JavaPowerFR/SCS/README.md

# SCS
SCS Interface For MyHOME Products Legrand BTicino
