JavaPowerFR/SCS/Hardware/04_reverse_engineering.jpg

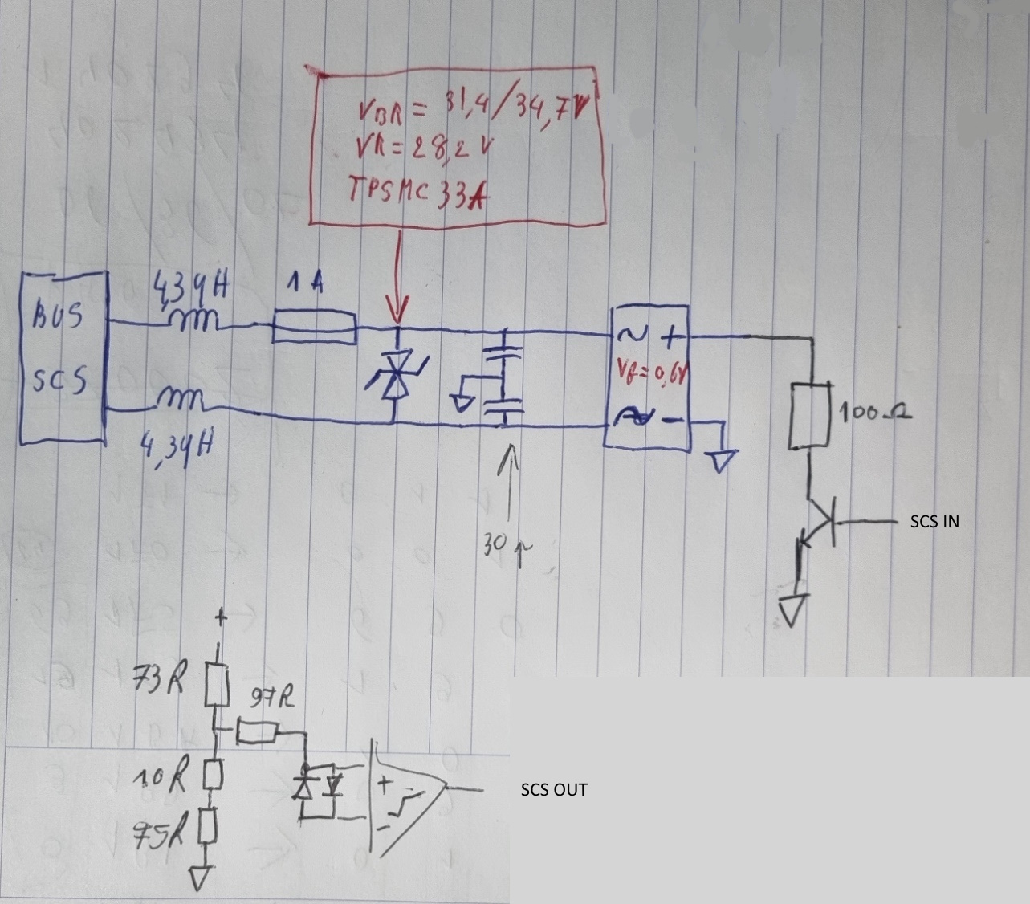
Hardware/04_reverse_engineering.jpg
