JavaPowerFR/SCS/Hardware/First_Interface_bb.jpg

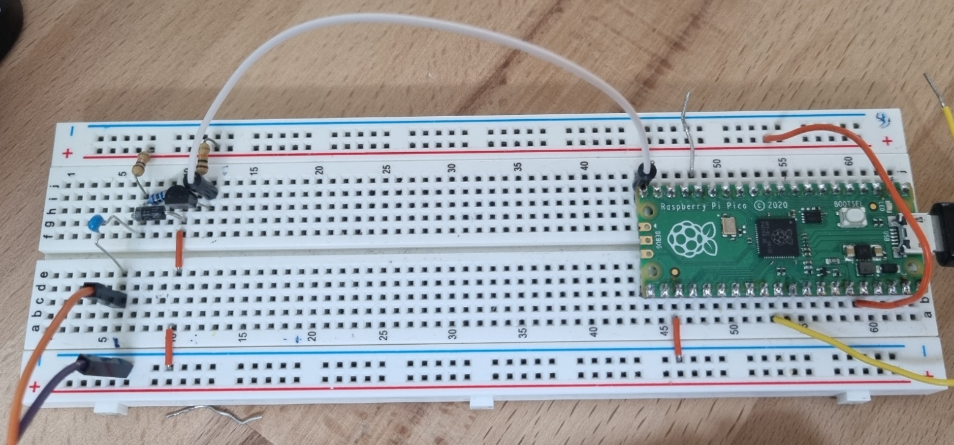
Hardware/First_Interface_bb.jpg
