JavaPowerFR/SCS/Hardware/First_Interface_ocilo.png

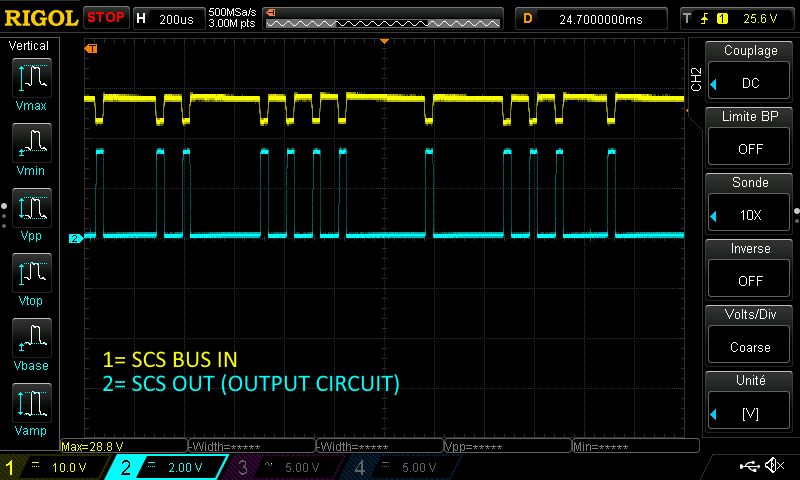
Hardware/First_Interface_ocilo.png
