JavaPowerFR/SCS/Hardware/First_Interface_schematic.png

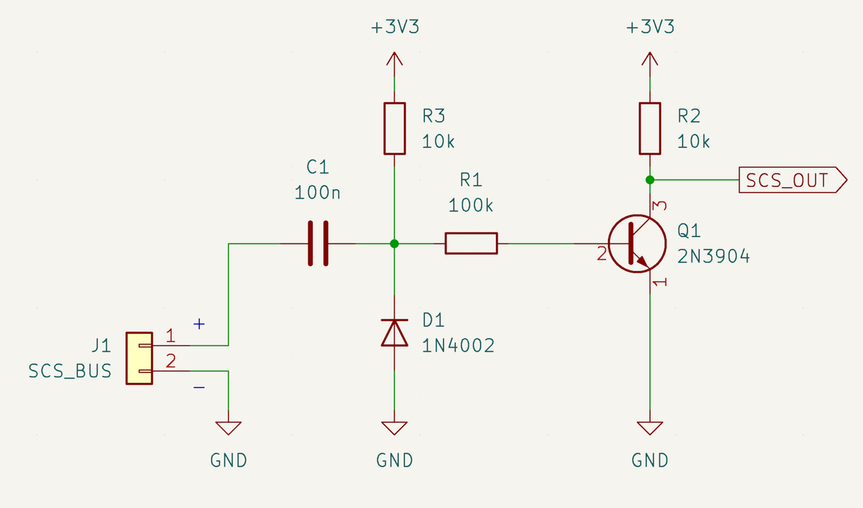
Hardware/First_Interface_schematic.png
