JavaPowerFR/SCS/Hardware/SCS Interface V1/3D_lte_V1.png

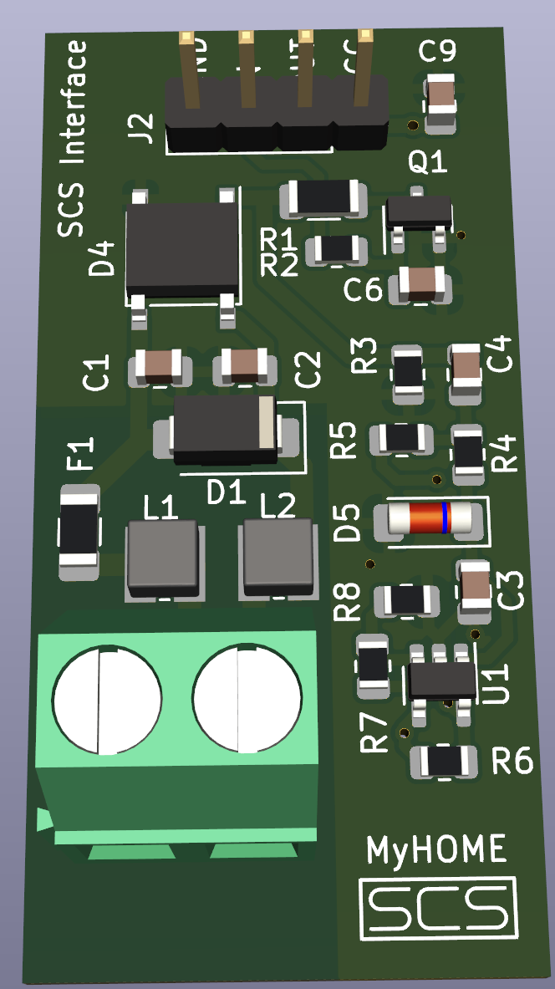
Hardware/SCS Interface V1/3D_lte_V1.png
