JavaPowerFR/SCS/Hardware/SCS Interface V1/3D_with_power_V1.png

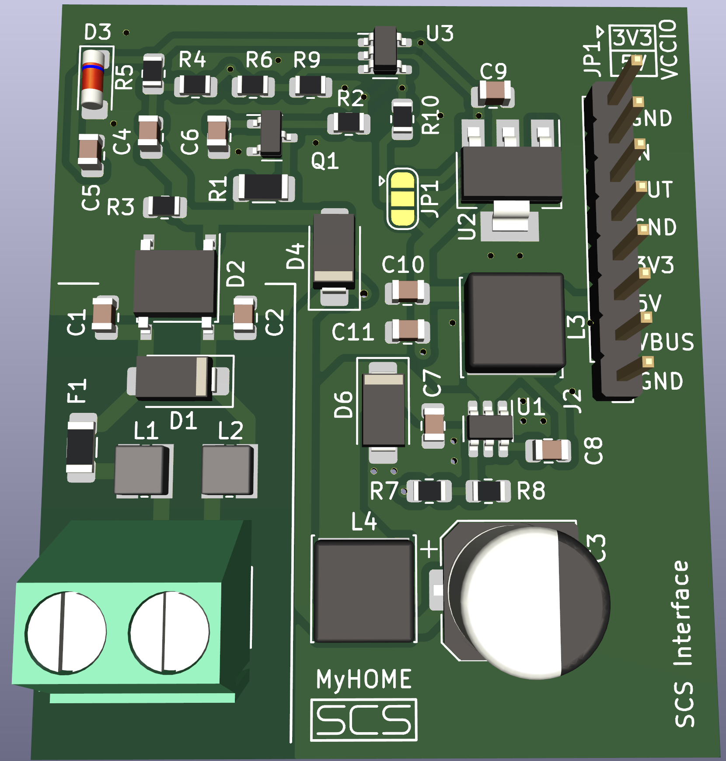
Hardware/SCS Interface V1/3D_with_power_V1.png
