JavaPowerFR/SCS/Hardware/SCS Interface V1/PCB_lte_V1.png

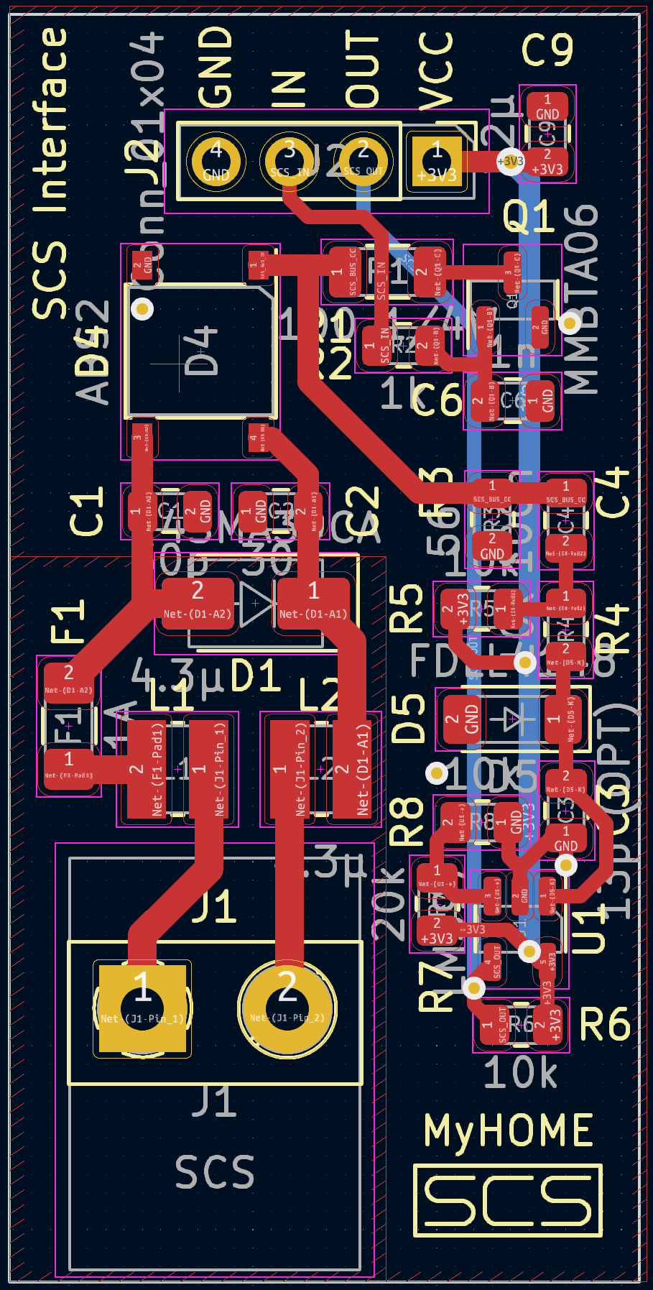
Hardware/SCS Interface V1/PCB_lte_V1.png
