JavaPowerFR/SCS/Hardware/SCS Interface V1/PCB_with_power_V1.png

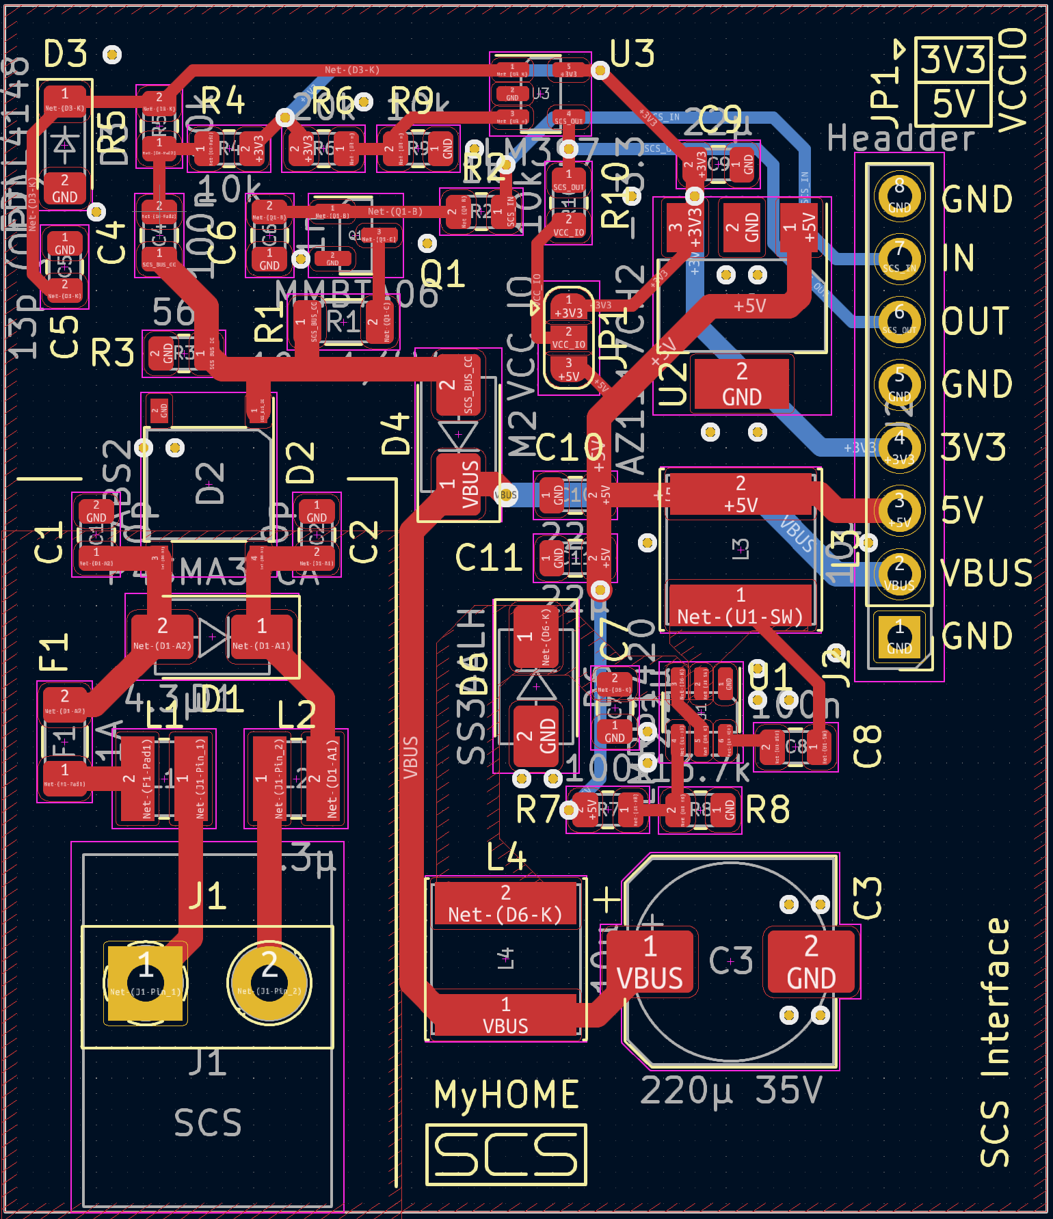
Hardware/SCS Interface V1/PCB_with_power_V1.png
