JavaPowerFR/SCS/Hardware/SCS Interface V1/schematic_with_power_V1.png

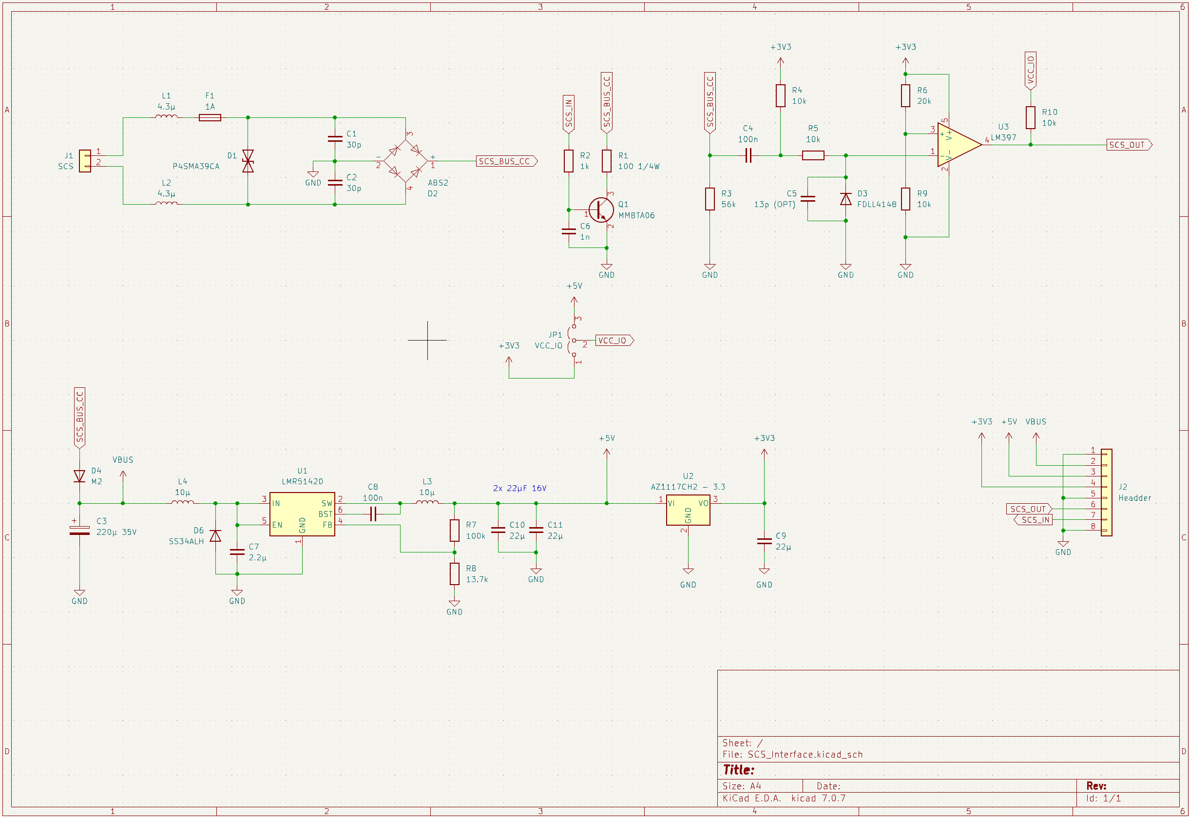
Hardware/SCS Interface V1/schematic_with_power_V1.png
