JavaPowerFR/SCS/Software/Decryptor Application/bp_1_ON_OFF.png

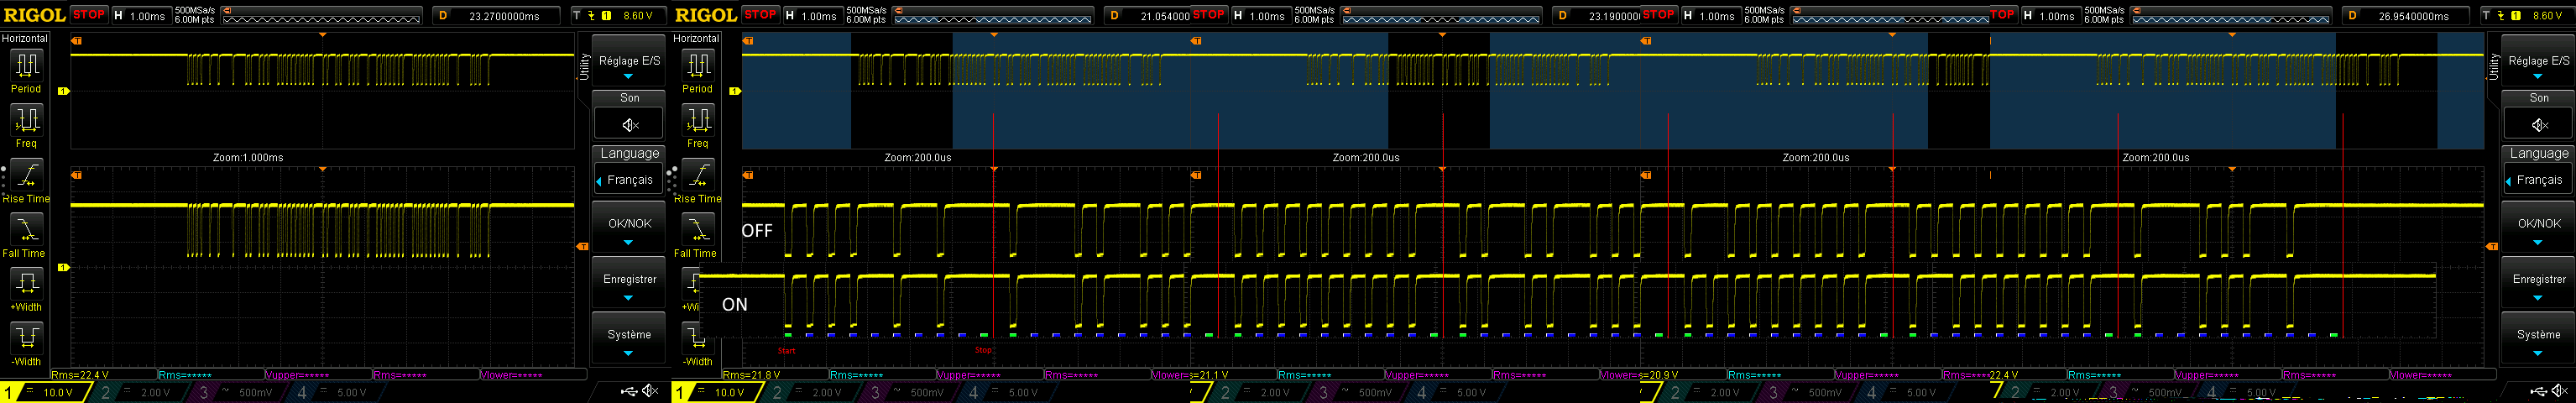
Software/Decryptor Application/bp_1_ON_OFF.png
