JavaPowerFR/SCS/Software/Decryptor Application/protocol_and_timming.png

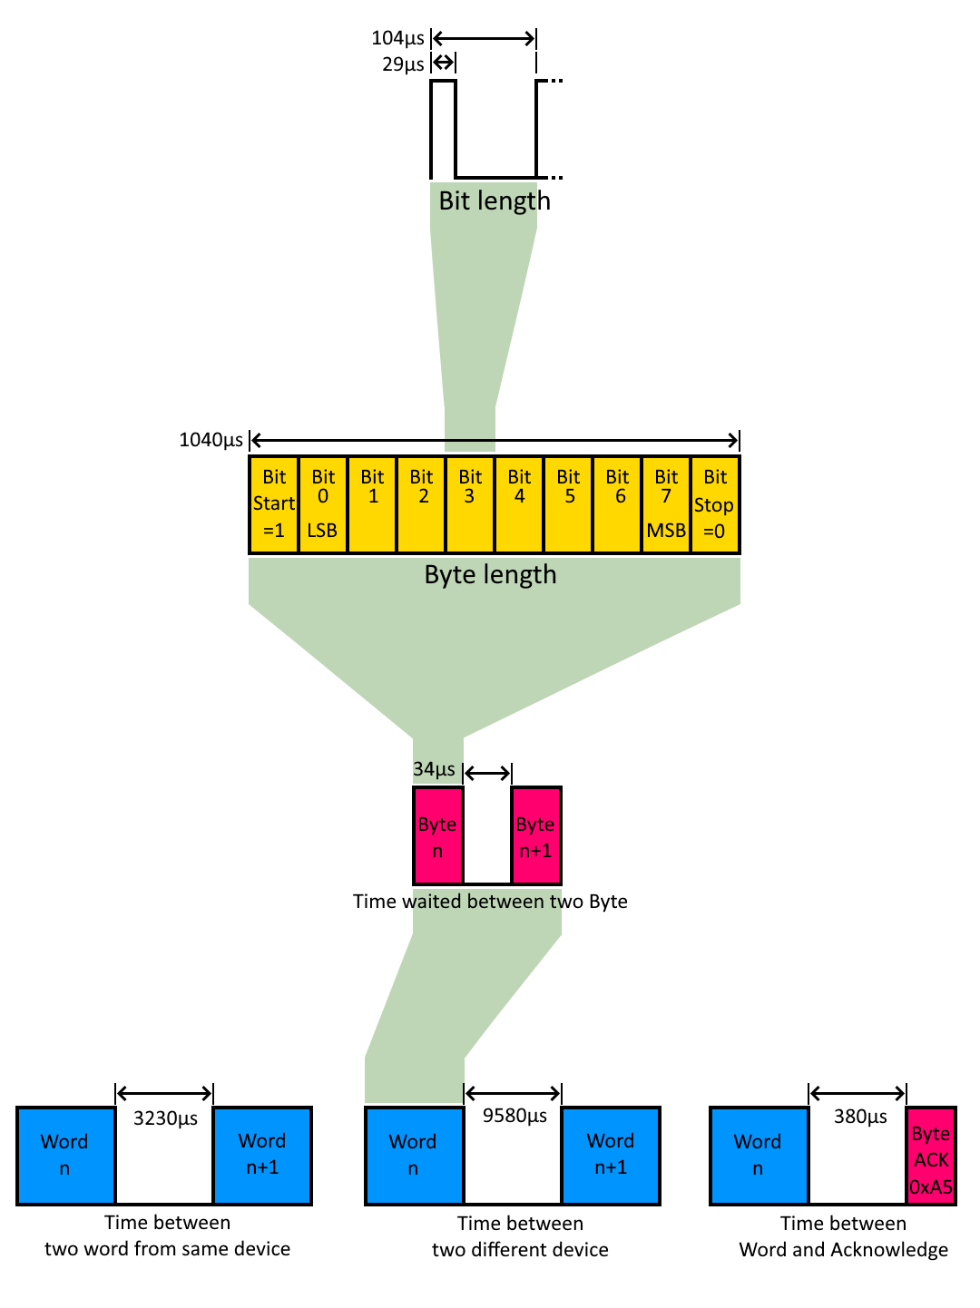
Software/Decryptor Application/protocol_and_timming.png
