JavaPowerFR/SCS/Resources/OPENDB_EN_OPEN.xlsx

Sheet: OPENDB_EN_OPEN
id_open | open_label | descr | open_string | scs_command | has_address | has_param | open_type | diag_open | error_open | open4keyo | note
1 | res_object_model | device answer its object model and number of physical configurator | *#[WHO]*[WHERE]*1*[OBJECT_MODEL]*[N_CONF]*[BRAND]*[LINE]## | 0xD2:[WHERE]:[TYPE]:0x34:0x80:[N_CONF]:[BRAND_LINE]:[OBJECT_MODEL] | 1 | 1 | 0 | 1 | 0 | 0
2 | res_fw_version | device answer its firmware version | *#[WHO]*[WHERE]*2*[FW_VERSION]## | 0xD2:[WHERE]:[TYPE]:0x34:0x81:[VERSION]:[V_RELEASE]:[V_BUILD] | 0 | 1 | 0 | 1 | 0 | 0
3 | res_hw_version | device answer its hardware version | *#[WHO]*[WHERE]*3*[HW_VERSION]## | 0xD2:[WHERE]:[TYPE]:0x34:0x82:[VERSION]:[V_RELEASE]:[V_BUILD] | 0 | 1 | 0 | 1 | 0 | 0
4 | res_conf_1_6 | device answer its configurator from 1 to 6 | *#[WHO]*[WHERE]*4*[C1]*[C2]*[C3]*[C4]*[C5]*[C6]## | 0xD2:[WHERE]:[TYPE]:0x34:0x83:[C1_C2]:[C3_C4]:[C5_C6] | 0 | 1 | 0 | 1 | 0 | 0
5 | res_conf_7_12 | device answer its configurator from 7 to 12 | *#[WHO]*[WHERE]*5*[C7]*[C8]*[C9]*[C10]*[C11]*[C12]## | 0xD2:[WHERE]:[TYPE]:0x34:0x84:[C7_C8]:[C9_C10]:[C11_C12] | 0 | 1 | 0 | 1 | 0 | 0
6 | res_micro_version | device answer its micro version | *#[WHO]*[WHERE]*6*[MICRO_VERSION]## | 0xD2:[WHERE]:[TYPE]:0x34:0x85:[VERSION]:[V_RELEASE]:[V_BUILD] | 0 | 1 | 0 | 1 | 0 | 0
7 | res_diag_a | device answer its diagnostic bitmask A | *#[WHO]*[WHERE]*7*[BITMASK_DIA_A]## | 0xD2:[WHERE]:[TYPE]:0x34:0x86:[BITMASK_DIA_A_3]:[BITMASK_DIA_A_2]:[BITMASK_DIA_A_1] | 0 | 1 | 0 | 1 | 0 | 0
8 | res_diag_b | device answer its diagnostic bitmask B | *#[WHO]*[WHERE]*8*[BITMASK_DIA_B]## | 0xD2:[WHERE]:[TYPE]:0x34:0x87:[BITMASK_DIA_B_3]:[BITMASK_DIA_B_2]:[BITMASK_DIA_B_1] | 0 | 1 | 0 | 1 | 0 | 0
9 | res_trans_end | device answer end of transmission | *[WHO]*4*[WHERE_FAKE]## | 0xD2:[WHERE]:[TYPE]:0x34:0x8C:0x00:0x00:0xAA | 1 | 0 | 0 | 1 | 0 | 0
10 | res_conf_wrong | device answer for wrong configuration | *[WHO]*51*[WHERE_FAKE]## | 0xD2:[WHERE]:[TYPE]:0x34:0x8C:0x00:0x00:0xEE | 1 | 0 | 0 | 1 | 1 | 0
11 | cmd_conf_end | programmer send end of configuration | *[WHO]*2*0## | 0xD2:0x00:[TYPE]:0x32:0x8C:0x00:0x00:0xFF | 0 | 0 | 1 | 1 | 0 | 0
12 | cmd_conf_abort | device abort configuration | *[WHO]*3*0## | 0xD2:0x00:[TYPE]:0x34:0x8C:0x00:[STATUS]:0xFA | 0 | 0 | 0 | 1 | 2 | 0
13 | cmd_conf_abort | programmer abort configuration | *[WHO]*3*0## | 0xD2:0x00:[TYPE]:0x32:0x8C:0x00:[STATUS]:0xFA | 0 | 0 | 1 | 1 | 0 | 0
14 | cmd_conf_del | programmer delete the configuration stored in the device memory | *[WHO]*7*0## | 0xD2:0x00:[TYPE]:0x32:0x8C:0x00:0x01:0xF0 | 0 | 0 | 1 | 1 | 0 | 0
15 | cmd_conf_start | programmer start configuration session | *[WHO]*1*0## | 0xD2:0x00:[TYPE]:0x32:0x8C:0x00:0x00:0x00 | 0 | 0 | 1 | 1 | 0 | 0
16 | cmd_trans_end | programmer answer end of transmission | *[WHO]*4*0## | 0xD2:0x00:[TYPE]:0x32:0x8C:0x00:0x00:0xAA | 0 | 0 | 1 | 1 | 0 | 0
17 | res_conf_ok | device answer configuration ok | *[WHO]*52*[WHERE_FAKE]## | 0xD2:[WHERE]:[TYPE]:0x34:0x8C:0x00:0x00:0xAB | 1 | 0 | 0 | 1 | 0 | 0
18 | cmd_conf_ID | programmer start configuration session with ID | *[WHO]*9#[ID]*0## | 0xD0:0x00:[TYPE]:0xF6:[DEVICE_ID_3]:[DEVICE_ID_2]:[DEVICE_ID_1]:[DEVICE_ID_0] | 0 | 1 | 1 | 1 | 0 | 0
19 | cmd_conf_start_add | programmer start configuration session with address | *[WHO]*1*[WHERE]## | 0xD2:[WHERE]:[TYPE]:0x32:0x8C:0x00:0x00:0x00 | 1 | 0 | 1 | 1 | 0 | 0
20 | res_id | device answer its ID | *#[WHO]*[WHERE]*13*[ID]## | 0xD0:[WHERE]:[TYPE]:0x04:[DEVICE_ID_3]:[DEVICE_ID_2]:[DEVICE_ID_1]:[DEVICE_ID_0] | 0 | 1 | 0 | 1 | 0 | 0
21 | res_ko_value | device answer its key_object, value and the state | *#[WHO]*[WHERE]*30*[SLOT]*[KEYO]*[STATE]## | 0xD2:[WHERE]:[TYPE]:0x34:0x8B:[KEYO_2]:[KEYO_1]:[SLOT] | 0 | 1 | 0 | 1 | 0 | 0
22 | res_ko_sys | device answer its key_object, system and address | *#[WHO]*[WHERE]*32#[SLOT]*[SYS]*[ADDR]## | 0xD2:[WHERE]:[TYPE]:0x34:0x8D:[SYS]:[ADDR]:[SLOT]>0x7F | 0 | 1 | 0 | 1 | 0 | 0
23 | cmd_conf_1_6 | programmer send the configuration of the configurators from 1 to 6 | *#[WHO]*0*#4*[C1]*[C2]*[C3]*[C4]*[C5]*[C6]## | 0xD2:0x00:[TYPE]:0x32:0x83:[C1_C2]:[C3_C4]:[C5_C6] | 0 | 1 | 1 | 1 | 0 | 0
24 | cmd_conf_7_12 | programmer send the configuration of the configurators from 7 to 12 | *#[WHO]*0*#5*[C7]*[C8]*[C9]*[C10]*[C11]*[C12]## | 0xD2:0x00:[TYPE]:0x32:0x84:[C7_C8]:[C9_C10]:[C11_C12] | 0 | 1 | 1 | 1 | 0 | 0
26 | res_param_ko | device answer the parameters of ko | *#[WHO]*[WHERE]*35#[INDEX]#[SLOT]*[VAL_PAR]## | 0xD2:[WHERE]:[TYPE]:0x34:0x8D:[VAL_PAR]:[INDEX]:[SLOT] | 0 | 1 | 0 | 1 | 0 | 0
27 | cmd_reset_all_ko | programmer reset all KO of device | *[WHO]*14#0*0## | 0xD2:0x00:[TYPE]:0x32:0x8B:0x00:0x00:0x80 | 0 | 0 | 1 | 1 | 0 | 0
28 | cmd_reset_ko | programmer reset a specific KO of device | *[WHO]*14#[SLOT]*0## | 0xD2:0x00:[TYPE]:0x32:0x8B:0x00:0x00:[SLOT]>0x80 | 0 | 1 | 1 | 1 | 0 | 1
29 | cmd_ko_value | programmer send the configuration of key_object, value | *#[WHO]*0*#30*[SLOT]*[KEYO]## | 0xD2:0x00:[TYPE]:0x32:0x8B:[KEYO_2]:[KEYO_1]:[SLOT] | 0 | 1 | 1 | 1 | 0 | 1
30 | cmd_ko_sys | programmer send the configuration of key_object, system and address | *#[WHO]*0*#32#[SLOT]*[SYS]*[ADDR]## | 0xD2:0x00:[TYPE]:0x42:0x8D:[SYS]:[ADDR]:[SLOT]>0x7F | 0 | 1 | 1 | 1 | 0 | 1
31 | cmd_param_ko | programmer send the configuration of the parameters of ko | *#[WHO]*0*#35#[INDEX]#[SLOT]*[VAL_PAR]## | 0xD2:0x00:[TYPE]:0x32:0x8D:[VAL_PAR]:[INDEX]:[SLOT] | 0 | 1 | 1 | 1 | 0 | 1
32 | cmd_diag_start | programmer start diagnostic session | *[WHO]*5*0## | 0xD2:0x00:[TYPE]:0x32:0x8C:0x00:0x01:0x00 | 0 | 0 | 1 | 1 | 0 | 0
33 | cmd_diag_start_add | programmer start diagnostic session with address | *#[WHO]*[WHERE]*0## | 0xD1:[WHERE]:[INTERFACE_TYPE]:0x42:0x8C:0x00:0x01:0x00 | 1 | 0 | 1 | 1 | 0 | 0
34 | cmd_diag_ID | programmer start diagnostic session with ID | *[WHO]*10#[ID]*0## | 0xD0:0x00:[TYPE]:0xF7:[DEVICE_ID_3]:[DEVICE_ID_2]:[DEVICE_ID_1]:[DEVICE_ID_0] | 0 | 1 | 1 | 1 | 0 | 0
35 | cmd_diag_abort | programmer abort diagnostic | *[WHO]*6*0## | 0xD2:0x00:[TYPE]:0x32:0x8C:0x00:0x01:0xFF | 0 | 0 | 1 | 1 | 0 | 0
36 | res_unset_ko_error | device answer KO not implemented | *#[WHO]*[WHERE]*31*[SLOT]*0*[STATE]## | 0xD2:[WHERE]:[TYPE]:0x34:0x8B:0xFF:0x00:[SLOT_STATE] | 0 | 1 | 0 | 1 | 1 | 1
37 | res_busy_ko_error | device answer KO busy | *#[WHO]*[WHERE]*31*[SLOT]*1*[STATE]## | 0xD2:[WHERE]:[TYPE]:0x34:0x8B:0xFF:0x01:[SLOT_STATE] | 0 | 1 | 0 | 1 | 2 | 0 | this error open is marked as error_open=2 because it can happen even during a dignosis sequance and it is just an info
38 | res_done_ko_error | device answer KO already configured | *#[WHO]*[WHERE]*31*[SLOT]*2*[STATE]## | 0xD2:[WHERE]:[TYPE]:0x34:0x8B:0xFF:0x02:[SLOT_STATE] | 0 | 1 | 0 | 1 | 1 | 1
39 | res_full_ko_error | device answer there are not enough free KO | *#[WHO]*[WHERE]*31*[SLOT]*3*[STATE]## | 0xD2:[WHERE]:[TYPE]:0x34:0x8B:0xFF:0x03:[SLOT_STATE] | 0 | 1 | 0 | 1 | 1 | 1
40 | res_wrong_ko_error | device answer not implemented this KO | *#[WHO]*[WHERE]*31*[SLOT]*4*[STATE]## | 0xD2:[WHERE]:[TYPE]:0x34:0x8B:0xFF:0x04:[SLOT_STATE] | 0 | 1 | 0 | 1 | 1 | 1 | State = 0x80
41 | res_addr_ko_error | device answer KO address error | *#[WHO]*[WHERE]*34*[SLOT]*[ERROR]## |  | 0 | 1 | 0 | 1 | 1 | 1
42 | res_param_ko_error | device answer parameter of KO error | *#[WHO]*[WHERE]*39*[SLOT]*[INDEX]*[ERROR]## |  | 0 | 1 | 0 | 1 | 2 | 1 | this error open is marked as error_open=2 because some parameters can be unmanaged by the device but the error should not stop the configuration
43 | cmd_scan_room | programmer start scan for room | *#[WHO]*[A]*1## | 0xD5:[WHERE_IID_A]:[TYPE]:0x43:0x80:0x00:0x00:0x00 | 0 | 1 | 1 | 1 | 0 | 0
44 | cmd_reset | programmer delete from memory the previous scans | *[WHO]*12*0## | 0xD0:0x00:[TYPE]:0xFB:0x00:0x00:0x00:0x00 | 0 | 0 | 1 | 1 | 0 | 0
45 | cmd_scan_all | programmer start scan for all devices with ID | *#[WHO]*0*13## | 0xD0:0x00:[TYPE]:0xF3:0x00:0x00:0x00:0x00 | 0 | 0 | 1 | 1 | 0 | 0
46 | cmd_scan_conf | programmer start scan for only devices configured with ID | *#[WHO]*0*13#1## | 0xD0:0x00:[TYPE]:0xF9:0x00:0x00:0x00:0x00 | 0 | 0 | 1 | 1 | 0 | 0
47 | cmd_scan_notconf | programmer start scan for only devices not configured with ID | *#[WHO]*0*13#0## | 0xD0:0x00:[TYPE]:0xF8:0x00:0x00:0x00:0x00 | 0 | 0 | 1 | 1 | 0 | 0
48 | cmd_scan_check | programmer send flag to all the devices found | *[WHO]*11#[ID]*0## | 0xD0:0x00:[TYPE]:0xFA:[DEVICE_ID_3]:[DEVICE_ID_2]:[DEVICE_ID_1]:[DEVICE_ID_0] | 0 | 1 | 1 | 1 | 0 | 0
49 | cmd_scan_term | programmer start scan of termoregulation | *#[WHO]*00[ZAZB]*1## | /!\ 0xD5:[ZAZB]:0x03:0x33:0x80:0x00:0x00:0x00 | 0 | 1 | 1 | 1 | 0 | 0
50 | cmd_test | programmer send test | *[WHO]*[WHAT]*[WHERE]## |  | 1 | 1 | 1 | 0 | 0 | 0
51 | res_test | device answer test | *[WHO]*[WHAT]*[WHERE]## |  | 0 | 1 | 0 | 0 | 0 | 0
52 | cmd_lux | programmer sent level of LUX | *#[WHO]*[WHERE]*6## |  | 1 | 0 | 1 | 0 | 0 | 0
53 | res_lux | device answer level of LUX | *#[WHO]*[WHERE]*6*[LEVELLUX]## |  | 1 | 1 | 0 | 0 | 0 | 0
54 | cmd_tar_start | programmer star calibration | *[WHO]*1000#33#1*[WHERE]## |  | 1 | 0 | 1 | 0 | 0 | 0
55 | cmd_tar_end | programmer end calibration | *[WHO]*1000#33#0*[WHERE]## |  | 1 | 0 | 1 | 0 | 0 | 0
56 | res_tar_ok | device send start/end calibration | *[WHO]*33#1*[WHERE]## |  | 0 | 0 | 0 | 0 | 0 | 0
57 | cmd_lux_conf | programmer send the configuration of level of LUX | *#[WHO]*[WHERE]*#6*[LEVELLUX]## |  | 1 | 1 | 1 | 0 | 0 | 0
58 | res_lux_conf | device answer the configuration of level of LUX | *#[WHO]*[WHERE]*#6*[LEVELLUX]## |  | 0 | 1 | 0 | 0 | 0 | 0
59 | cmd_ident | programmer send open identification code for the service | *[WHO]*[WHAT]## |  | 0 | 1 | 1 | 0 | 0 | 0
60 | res_oper | device answer the caller a string representing the sequence of logic operations to be applied to the password | *#[OPERATIONS]## |  | 0 | 1 | 0 | 0 | 0 | 0
61 | cmd_result | programmer send the result of password | *#[RESULT]## |  | 0 | 1 | 1 | 0 | 0 | 0
62 | cmd_diag_general | programmer send the request of general diagnostic A of device system | *#[WHO]**7## |  | 0 | 0 | 1 | 1 | 0 | 0
63 | res_diag_bit | device answer the mask of autodiagnostic | *#[WHO]**7*[BIT]## |  | 0 | 1 | 0 | 1 | 0 | 0
64 | res_autodiag_bit | device answer the mask of autodiagnostic when there are problems hardware/software | *#[WHO]**11*[BIT]## |  | 0 | 1 | 0 | 1 | 0 | 0
65 | cmd_webserver | programmer send model of WebServer | *#[WHO]**15## |  | 0 | 0 | 1 | 0 | 0 | 0
66 | cmd_mac | programmer send mac address | *#[WHO]**12## |  | 0 | 0 | 1 | 0 | 0 | 0
67 | res_webserver | device answer object_model of WebServer | *#[WHO]**15*[OBJECT_MODEL]## |  | 0 | 1 | 0 | 0 | 0 | 0
68 | res_mac | device answer mac address | *#[WHO]**12*[MAC1]*[MAC2]*[MAC3]*[MAC4]*[MAC5]*[MAC6]## |  | 0 | 1 | 0 | 0 | 0 | 0
69 | cmd_prog_sce_start | programmer start of programming of scenario | *[WHO]*15#1[SCE]*0## |  | 0 | 1 | 1 | 1 | 0 | 0
70 | cmd_reset_sce | programmer send to reset scenario | *[WHO]*18#1[SCE]*0## |  | 0 | 1 | 1 | 1 | 0 | 0
72 | cmd_prog_sce_end | programmer end of programming of scenario | *[WHO]*16#1[SCE]*0## |  | 0 | 1 | 1 | 1 | 0 | 0
73 | cmd_set_state | programmer send to set PPT_SCE state | *#[WHO]*[WHERE]*#40#1[SCE]*[STATE_SCE]## |  | 1 | 1 | 1 | 1 | 0 | 0
74 | cmd_state | programmer send the state of scenario | *#[WHO]*[WHERE]*40#1[SCE]## |  | 1 | 1 | 1 | 1 | 0 | 0
75 | res_state | device answer the state of scenario | *#[WHO]*[WHERE]*40#1[SCE]*[STATE_SCE]## |  | 0 | 1 | 0 | 1 | 0 | 0
76 | res_error_sce | device answer with error to the scenario | *#[WHO]*[WHERE]*41#1[SCE]*[ERROR]## |  | 0 | 1 | 0 | 1 | 1 | 0
77 | cmd_test_sce | programmer sent scenario activation | *[WHO]*11#0*1[SCE]## |  | 0 | 1 | 1 | 0 | 0 | 0
78 | res_param_ko_special | device answer the special parameter of ko | *#[WHO]*[WHERE]*310*[SLOT]*[VAL_PAR]## |  | 0 | 1 | 0 | 1 | 0 | 0
79 | ack | ack | *#*1## | 0xA5 | 0 | 0 | 0 | 0 | 0 | 0
80 | nack | nack | *#*0## |  | 0 | 0 | 0 | 0 | 0 | 0
81 | ack | ack | *#*1## | 0xA5 | 0 | 0 | 1 | 0 | 0 | 0
82 | nack | nack | *#*0## |  | 0 | 0 | 1 | 0 | 0 | 0
83 | cmd_param_all_ko | reset keyo on all slot | *#[WHO]*0*38#0## | 0xD2:0x00:[TYPE]:0x33:0x8D:0x06:0x00:0x00 | 0 | 0 | 1 | 1 | 0 | 0 | the same command as ID OPEN 25 reset all slot
25 | cmd_param_ko | reset keyo on selected slot | *#[WHO]*0*38#[SLOT]## |  | 0 | 1 | 1 | 1 | 0 | 0 | the same command as ID OPEN 83 reset a specific slot
84 | cmd_diag_abort | device abort diagnostic | *[WHO]*6*0## |  | 0 | 0 | 0 | 0 | 2 | 0
85 | cmd_scan_start_addr | programmer start scan session with address | *#[WHO]*[WHERE]*1## |  | 1 | 0 | 1 | 0 | 0 | 0
86 | res_trans_end | device answer end of transmission | *[WHO]*4*0## |  | 0 | 0 | 0 | 1 | 0 | 0 | variant of id open = 9
87 | res_conf_wrong | device answer for wrong configuration | *[WHO]*51*0## |  | 0 | 0 | 0 | 1 | 1 | 0 | variant of id open = 10
88 | res_conf_ok | device answer configuration ok | *[WHO]*52*0## |  | 0 | 0 | 0 | 1 | 0 | 0 | variant of id open = 17
89 | res_object_model_gateway | gateway answer its object model and number of physical configurator | *#[WHO]**1*[OBJECT_MODEL]*[N_CONF]*[BRAND]*[LINE]## |  | 1 | 1 | 0 | 1 | 0 | 0

Sheet: Feuil1
1 | res_object_model | device answer its object model and number of physical configurator | *#[WHO]*[WHERE]*1*[OBJECT_MODEL]*[N_CONF]*[BRAND]*[LINE]## | 0xD2 | [WHERE] | [TYPE] | 0x34 | 0x80 | [N_CONF] | [BRAND_LINE] | [OBJECT_MODEL]
 |  | device answer its object model and number of physical configurator (over interface) | *#[WHO]*[WHERE]#4#[INTERFACE]*1*[OBJECT_MODEL]*[N_CONF]*[BRAND]*[LINE]## | 0xD2 | [WHERE] | [INT_TYPE] | 0x44 | 0x80 | [N_CONF] | [BRAND_LINE] | [OBJECT_MODEL]
2 | res_fw_version | device answer its firmware version | *#[WHO]*[WHERE]*2*[FW_VERSION]## | 0xD2 | [WHERE] | [TYPE] | 0x34 | 0x81 | [VERSION] | [V_RELEASE] | [V_BUILD]
 |  | device answer its firmware version (over interface) | *#[WHO]*[WHERE]#4#[INTERFACE]*2*[FW_VERSION]## | 0xD2 | [WHERE] | [INT_TYPE] | 0x44 | 0x81 | [VERSION] | [V_RELEASE] | [V_BUILD]
3 | res_hw_version | device answer its hardware version | *#[WHO]*[WHERE]*3*[HW_VERSION]## | 0xD2 | [WHERE] | [TYPE] | 0x34 | 0x82 | [VERSION] | [V_RELEASE] | [V_BUILD]
 |  | device answer its hardware version (over interface) | *#[WHO]*[WHERE]#4#[INTERFACE]*3*[HW_VERSION]## | 0xD2 | [WHERE] | [INT_TYPE] | 0x44 | 0x82 | [VERSION] | [V_RELEASE] | [V_BUILD]
4 | res_conf_1_6 | device answer its configurator from 1 to 6 | *#[WHO]*[WHERE]*4*[C1]*[C2]*[C3]*[C4]*[C5]*[C6]## | 0xD2 | [WHERE] | [TYPE] | 0x34 | 0x83 | [C1_C2] | [C3_C4] | [C5_C6]
 |  | device answer its configurator from 1 to 6 (over interface) | *#[WHO]*[WHERE]#4#[INTERFACE]*4*[C1]*[C2]*[C3]*[C4]*[C5]*[C6]## | 0xD2 | [WHERE] | [INT_TYPE] | 0x44 | 0x83 | [C1_C2] | [C3_C4] | [C5_C6]
5 | res_conf_7_12 | device answer its configurator from 7 to 12 | *#[WHO]*[WHERE]*5*[C7]*[C8]*[C9]*[C10]*[C11]*[C12]## | 0xD2 | [WHERE] | [TYPE] | 0x34 | 0x84 | [C7_C8] | [C9_C10] | [C11_C12]
 |  | device answer its configurator from 7 to 12 (over interface) | *#[WHO]*[WHERE]#4#[INTERFACE]*5*[C7]*[C8]*[C9]*[C10]*[C11]*[C12]## | 0xD2 | [WHERE] | [INT_TYPE] | 0x44 | 0x84 | [C7_C8] | [C9_C10] | [C11_C12]
6 | res_micro_version | device answer its micro version | *#[WHO]*[WHERE]*6*[MICRO_VERSION]## | 0xD2 | [WHERE] | [TYPE] | 0x34 | 0x85 | [VERSION] | [V_RELEASE] | [V_BUILD]
 |  | device answer its micro version (over interface) | *#[WHO]*[WHERE]#4#[INTERFACE]*6*[MICRO_VERSION]## | 0xD2 | [WHERE] | [INT_TYPE] | 0x44 | 0x85 | [VERSION] | [V_RELEASE] | [V_BUILD]
7 | res_diag_a | device answer its diagnostic bitmask A | *#[WHO]*[WHERE]*7*[BITMASK_DIA_A]## | 0xD2 | [WHERE] | [TYPE] | 0x34 | 0x86 | [BITMASK_DIA_A_3] | [BITMASK_DIA_A_2] | [BITMASK_DIA_A_1]
 |  | device answer its diagnostic bitmask A (over interface) | *#[WHO]*[WHERE]#4#[INTERFACE]*7*[BITMASK_DIA_A]## | 0xD2 | [WHERE] | [INT_TYPE] | 0x44 | 0x86 | [BITMASK_DIA_A_3] | [BITMASK_DIA_A_2] | [BITMASK_DIA_A_1]
8 | res_diag_b | device answer its diagnostic bitmask B | *#[WHO]*[WHERE]*8*[BITMASK_DIA_B]## | 0xD2 | [WHERE] | [TYPE] | 0x34 | 0x87 | [BITMASK_DIA_B_3] | [BITMASK_DIA_B_2] | [BITMASK_DIA_B_1]
 |  | device answer its diagnostic bitmask B (over interface) | *#[WHO]*[WHERE]#4#[INTERFACE]*8*[BITMASK_DIA_B]## | 0xD2 | [WHERE] | [INT_TYPE] | 0x44 | 0x87 | [BITMASK_DIA_B_3] | [BITMASK_DIA_B_2] | [BITMASK_DIA_B_1]
9 | res_trans_end | device answer end of transmission | *[WHO]*4*[WHERE_FAKE]## | 0xD2 | [WHERE] | [TYPE] | 0x34 | 0x8C | 0x00 | 0x00 | 0xAA
 |  | device answer end of transmission (over interface) |  | 0xD2 | [WHERE] | [INT_TYPE] | 0x44 | 0x8C | 0x00 | 0x00 | 0xAA
10 | res_conf_wrong | device answer for wrong configuration | *[WHO]*51*[WHERE_FAKE]## | 0xD2 | [WHERE] | [TYPE] | 0x34 | 0x8C | 0x00 | 0x00 | 0xEE
 |  | device answer for wrong configuration (over interface) |  | 0xD2 | [WHERE] | [INT_TYPE] | 0x44 | 0x8C | 0x00 | 0x00 | 0xEE
11 | cmd_conf_end | programmer send end of configuration | *[WHO]*2*0## | 0xD2 | 0x00 | [TYPE] | 0x32 | 0x8C | 0x00 | 0x00 | 0xFF
12 | cmd_conf_abort | device abort configuration | *[WHO]*3*0## | 0xD2 | 0x00 | [TYPE] | 0x34 | 0x8C | 0x00 | [STATUS] | 0xFA
 |  | device abort configuration (over interface) |  | 0xD2 | 0x00 | [INT_TYPE] | 0x44 | 0x8C | 0x00 | [STATUS] | 0xFA
13 | cmd_conf_abort | programmer abort configuration | *[WHO]*3*0## | 0xD2 | 0x00 | [TYPE] | 0x32 | 0x8C | 0x00 | [STATUS] | 0xFA
14 | cmd_conf_del | programmer delete the configuration stored in the device memory | *[WHO]*7*0## | 0xD2 | 0x00 | [TYPE] | 0x32 | 0x8C | 0x00 | 0x01 | 0xF0
15 | cmd_conf_start | programmer start configuration session | *[WHO]*1*0## | 0xD2 | 0x00 | [TYPE] | 0x32 | 0x8C | 0x00 | 0x00 | 0x00
16 | cmd_trans_end | programmer answer end of transmission | *[WHO]*4*0## | 0xD2 | 0x00 | [TYPE] | 0x32 | 0x8C | 0x00 | 0x00 | 0xAA
17 | res_conf_ok | device answer configuration ok | *[WHO]*52*[WHERE_FAKE]## | 0xD2 | [WHERE] | [TYPE] | 0x34 | 0x8C | 0x00 | 0x00 | 0xAB
 |  | device answer configuration ok (over interface) |  | 0xD2 | [WHERE] | [INT_TYPE] | 0x44 | 0x8C | 0x00 | 0x00 | 0xAB
18 | cmd_conf_ID | programmer start configuration session with ID | *[WHO]*9#[ID]*0## | 0xD0 | 0x00 | [TYPE] | 0xF6 | [DEVICE_ID_3] | [DEVICE_ID_2] | [DEVICE_ID_1] | [DEVICE_ID_0]
19 | cmd_conf_start_add | programmer start configuration session with address | *[WHO]*1*[WHERE]## | 0xD2 | [WHERE] | [TYPE] | 0x32 | 0x8C | 0x00 | 0x00 | 0x00
20 | res_id | device answer its ID | *#[WHO]*[WHERE]*13*[ID]## | 0xD0 | [WHERE] | [TYPE] | 0x04 | [DEVICE_ID_3] | [DEVICE_ID_2] | [DEVICE_ID_1] | [DEVICE_ID_0]
 |  | device answer its ID (over interface) | *#[WHO]*[WHERE]#4#[INTERFACE]*13*[ID]## | 0xD0 | [WHERE] | [INT_TYPE] | 0x44 | [DEVICE_ID_3] | [DEVICE_ID_2] | [DEVICE_ID_1] | [DEVICE_ID_0]
21 | res_ko_value | device answer its key_object, value and the state | *#[WHO]*[WHERE]*30*[SLOT]*[KEYO]*[STATE]## | 0xD2 | [WHERE] | [TYPE] | 0x34 | 0x8B | [KEYO_2] | [KEYO_1] | [SLOT]
 |  | device answer its key_object, value and the state (over interface) |  | 0xD2 | [WHERE] | [INT_TYPE] | 0x44 | 0x8B | [KEYO_2] | [KEYO_1] | [SLOT]
22 | res_ko_sys | device answer its key_object, system and address | *#[WHO]*[WHERE]*32#[SLOT]*[SYS]*[ADDR]## | 0xD2 | [WHERE] | [TYPE] | 0x34 | 0x8D | [SYS] | [ADDR] | [SLOT]>0x7F
 |  | device answer its key_object, system and address (over interface) |  | 0xD2 | [WHERE] | [INT_TYPE] | 0x44 | 0x8D | [SYS] | [ADDR] | [SLOT]>0x7F
23 | cmd_conf_1_6 | programmer send the configuration of the configurators from 1 to 6 | *#[WHO]*0*#4*[C1]*[C2]*[C3]*[C4]*[C5]*[C6]## | 0xD2 | 0x00 | [TYPE] | 0x32 | 0x83 | [C1_C2] | [C3_C4] | [C5_C6]
24 | cmd_conf_7_12 | programmer send the configuration of the configurators from 7 to 12 | *#[WHO]*0*#5*[C7]*[C8]*[C9]*[C10]*[C11]*[C12]## | 0xD2 | 0x00 | [TYPE] | 0x32 | 0x84 | [C7_C8] | [C9_C10] | [C11_C12]
26 | res_param_ko | device answer the parameters of ko | *#[WHO]*[WHERE]*35#[INDEX]#[SLOT]*[VAL_PAR]## | 0xD2 | [WHERE] | [TYPE] | 0x34 | 0x8D | [VAL_PAR] | [INDEX] | [SLOT]
 |  | device answer the parameters of ko (over interface) |  | 0xD2 | [WHERE] | [INT_TYPE] | 0x44 | 0x8D | [VAL_PAR] | [INDEX] | [SLOT]
27 | cmd_reset_all_ko | programmer reset all KO of device | *[WHO]*14#0*0## | 0xD2 | 0x00 | [TYPE] | 0x32 | 0x8B | 0x00 | 0x00 | 0x80
28 | cmd_reset_ko | programmer reset a specific KO of device | *[WHO]*14#[SLOT]*0## | 0xD2 | 0x00 | [TYPE] | 0x32 | 0x8B | 0x00 | 0x00 | [SLOT]>0x80
29 | cmd_ko_value | programmer send the configuration of key_object, value | *#[WHO]*0*#30*[SLOT]*[KEYO]## | 0xD2 | 0x00 | [TYPE] | 0x32 | 0x8B | [KEYO_2] | [KEYO_1] | [SLOT]
30 | cmd_ko_sys | programmer send the configuration of key_object, system and address | *#[WHO]*0*#32#[SLOT]*[SYS]*[ADDR]## | 0xD2 | 0x00 | [TYPE] | 0x42 | 0x8D | [SYS] | [ADDR] | [SLOT]>0x7F
31 | cmd_param_ko | programmer send the configuration of the parameters of ko | *#[WHO]*0*#35#[INDEX]#[SLOT]*[VAL_PAR]## | 0xD2 | 0x00 | [TYPE] | 0x32 | 0x8D | [VAL_PAR] | [INDEX] | [SLOT]
32 | cmd_diag_start | programmer start diagnostic session | *[WHO]*5*0## | 0xD2 | 0x00 | [TYPE] | 0x32 | 0x8C | 0x00 | 0x01 | 0x00
33 | cmd_diag_start_add | programmer start diagnostic session with address | *#[WHO]*[WHERE]*0## | 0xD1 | [WHERE] | [INTERFACE_TYPE] | 0x42 | 0x8C | 0x00 | 0x01 | 0x00
34 | cmd_diag_ID | programmer start diagnostic session with ID | *[WHO]*10#[ID]*0## | 0xD0 | 0x00 | [TYPE] | 0xF7 | [DEVICE_ID_3] | [DEVICE_ID_2] | [DEVICE_ID_1] | [DEVICE_ID_0]
35 | cmd_diag_abort | programmer abort diagnostic | *[WHO]*6*0## | 0xD2 | 0x00 | [TYPE] | 0x32 | 0x8C | 0x00 | 0x01 | 0xFF
36 | res_unset_ko_error | device answer KO not implemented | *#[WHO]*[WHERE]*31*[SLOT]*0*[STATE]## | 0xD2 | [WHERE] | [TYPE] | 0x34 | 0x8B | 0xFF | 0x00 | [SLOT_STATE]
 |  | device answer KO not implemented (over interface) |  | 0xD2 | [WHERE] | [INT_TYPE] | 0x44 | 0x8B | 0xFF | 0x00 | [SLOT_STATE]
37 | res_busy_ko_error | device answer KO busy | *#[WHO]*[WHERE]*31*[SLOT]*1*[STATE]## | 0xD2 | [WHERE] | [TYPE] | 0x34 | 0x8B | 0xFF | 0x01 | [SLOT_STATE]
 |  | device answer KO busy (over interface) |  | 0xD2 | [WHERE] | [INT_TYPE] | 0x44 | 0x8B | 0xFF | 0x01 | [SLOT_STATE]
38 | res_done_ko_error | device answer KO already configured | *#[WHO]*[WHERE]*31*[SLOT]*2*[STATE]## | 0xD2 | [WHERE] | [TYPE] | 0x34 | 0x8B | 0xFF | 0x02 | [SLOT_STATE]
 |  | device answer KO already configured (over interface) |  | 0xD2 | [WHERE] | [INT_TYPE] | 0x44 | 0x8B | 0xFF | 0x02 | [SLOT_STATE]
39 | res_full_ko_error | device answer there are not enough free KO | *#[WHO]*[WHERE]*31*[SLOT]*3*[STATE]## | 0xD2 | [WHERE] | [TYPE] | 0x34 | 0x8B | 0xFF | 0x03 | [SLOT_STATE]
 |  | device answer there are not enough free KO (over interface) |  | 0xD2 | [WHERE] | [INT_TYPE] | 0x44 | 0x8B | 0xFF | 0x03 | [SLOT_STATE]
40 | res_wrong_ko_error | device answer not implemented this KO | *#[WHO]*[WHERE]*31*[SLOT]*4*[STATE]## | 0xD2 | [WHERE] | [TYPE] | 0x34 | 0x8B | 0xFF | 0x04 | [SLOT_STATE]
 |  | device answer not implemented this KO (over interface) |  | 0xD2 | [WHERE] | [INT_TYPE] | 0x44 | 0x8B | 0xFF | 0x04 | [SLOT_STATE]
41 | res_addr_ko_error | device answer KO address error | *#[WHO]*[WHERE]*34*[SLOT]*[ERROR]## | 0xD2 | [WHERE] | [TYPE] | 0x34 | 0x8D | [ERROR]>0xFD | !0x00 | [SLOT]>0x80 | ok | ERROR=0xFF =>TRUE
 |  | device answer KO address error (over interface) |  | 0xD2 | [WHERE] | [INT_TYPE] | 0x44 | 0x8D | [ERROR]>0xFD | !0x00 | [SLOT]>0x80
42 | res_param_ko_error | device answer parameter of KO error | *#[WHO]*[WHERE]*39*[SLOT]*[INDEX]*[ERROR]## | 0xD2 | [WHERE] | [TYPE] | 0x34 |  |  |  |  | !
 |  | device answer parameter of KO error (over interface) |  | 0xD2 | [WHERE] | [INT_TYPE] | 0x44
43 | cmd_scan_room | programmer start scan for room | *#[WHO]*[A]*1## | 0xD5 | [WHERE_IID_A] | [TYPE] | 0x43 | 0x80 | 0x00 | 0x00 | 0x00
44 | cmd_reset | programmer delete from memory the previous scans | *[WHO]*12*0## | 0xD0 | 0x00 | [TYPE] | 0xFB | 0x00 | 0x00 | 0x00 | 0x00
45 | cmd_scan_all | programmer start scan for all devices with ID | *#[WHO]*0*13## | 0xD0 | 0x00 | [TYPE] | 0xF3 | 0x00 | 0x00 | 0x00 | 0x00
46 | cmd_scan_conf | programmer start scan for only devices configured with ID | *#[WHO]*0*13#1## | 0xD0 | 0x00 | [TYPE] | 0xF9 | 0x00 | 0x00 | 0x00 | 0x00
47 | cmd_scan_notconf | programmer start scan for only devices not configured with ID | *#[WHO]*0*13#0## | 0xD0 | 0x00 | [TYPE] | 0xF8 | 0x00 | 0x00 | 0x00 | 0x00
48 | cmd_scan_check | programmer send flag to all the devices found | *[WHO]*11#[ID]*0## | 0xD0 | 0x00 | [TYPE] | 0xFA | [DEVICE_ID_3] | [DEVICE_ID_2] | [DEVICE_ID_1] | [DEVICE_ID_0]
49 | cmd_scan_term | programmer start scan of termoregulation | *#[WHO]*00[ZAZB]*1## | /!\ 0xD5 | [ZAZB] | 0x03 | 0x33 | 0x80 | 0x00 | 0x00 | 0x00
50 | cmd_test | programmer send test | *[WHO]*[WHAT]*[WHERE]##
51 | res_test | device answer test | *[WHO]*[WHAT]*[WHERE]##
52 | cmd_lux | programmer sent level of LUX | *#[WHO]*[WHERE]*6##
53 | res_lux | device answer level of LUX | *#[WHO]*[WHERE]*6*[LEVELLUX]##
54 | cmd_tar_start | programmer star calibration | *[WHO]*1000#33#1*[WHERE]##
55 | cmd_tar_end | programmer end calibration | *[WHO]*1000#33#0*[WHERE]##
56 | res_tar_ok | device send start/end calibration | *[WHO]*33#1*[WHERE]##
57 | cmd_lux_conf | programmer send the configuration of level of LUX | *#[WHO]*[WHERE]*#6*[LEVELLUX]##
58 | res_lux_conf | device answer the configuration of level of LUX | *#[WHO]*[WHERE]*#6*[LEVELLUX]##
59 | cmd_ident | programmer send open identification code for the service | *[WHO]*[WHAT]##
60 | res_oper | device answer the caller a string representing the sequence of logic operations to be applied to the password | *#[OPERATIONS]##
61 | cmd_result | programmer send the result of password | *#[RESULT]##
62 | cmd_diag_general | programmer send the request of general diagnostic A of device system | *#[WHO]**7##
63 | res_diag_bit | device answer the mask of autodiagnostic | *#[WHO]**7*[BIT]##
64 | res_autodiag_bit | device answer the mask of autodiagnostic when there are problems hardware/software | *#[WHO]**11*[BIT]##
65 | cmd_webserver | programmer send model of WebServer | *#[WHO]**15##
66 | cmd_mac | programmer send mac address | *#[WHO]**12##
67 | res_webserver | device answer object_model of WebServer | *#[WHO]**15*[OBJECT_MODEL]##
68 | res_mac | device answer mac address | *#[WHO]**12*[MAC1]*[MAC2]*[MAC3]*[MAC4]*[MAC5]*[MAC6]##
69 | cmd_prog_sce_start | programmer start of programming of scenario | *[WHO]*15#1[SCE]*0##
70 | cmd_reset_sce | programmer send to reset scenario | *[WHO]*18#1[SCE]*0##
72 | cmd_prog_sce_end | programmer end of programming of scenario | *[WHO]*16#1[SCE]*0##
73 | cmd_set_state | programmer send to set PPT_SCE state | *#[WHO]*[WHERE]*#40#1[SCE]*[STATE_SCE]##
74 | cmd_state | programmer send the state of scenario | *#[WHO]*[WHERE]*40#1[SCE]##
75 | res_state | device answer the state of scenario | *#[WHO]*[WHERE]*40#1[SCE]*[STATE_SCE]##
76 | res_error_sce | device answer with error to the scenario | *#[WHO]*[WHERE]*41#1[SCE]*[ERROR]##
77 | cmd_test_sce | programmer sent scenario activation | *[WHO]*11#0*1[SCE]##
78 | res_param_ko_special | device answer the special parameter of ko | *#[WHO]*[WHERE]*310*[SLOT]*[VAL_PAR]##
79 | ack | ack | *#*1## | 0xA5
80 | nack | nack | *#*0##
81 | ack | ack | *#*1## | 0xA5
82 | nack | nack | *#*0##
83 | cmd_param_all_ko | reset keyo on all slot | *#[WHO]*0*38#0##
25 | cmd_param_ko | reset keyo on selected slot | *#[WHO]*0*38#[SLOT]##
84 | cmd_diag_abort | device abort diagnostic | *[WHO]*6*0##
85 | cmd_scan_start_addr | programmer start scan session with address | *#[WHO]*[WHERE]*1##
86 | res_trans_end | device answer end of transmission | *[WHO]*4*0##
87 | res_conf_wrong | device answer for wrong configuration | *[WHO]*51*0##
88 | res_conf_ok | device answer configuration ok | *[WHO]*52*0##
89 | res_object_model_gateway | gateway answer its object model and number of physical configurator | *#[WHO]**1*[OBJECT_MODEL]*[N_CONF]*[BRAND]*[LINE]##
