JavaPowerFR/SCS/Hardware/SCS Interface V1/TestOnBreadboard.jpg

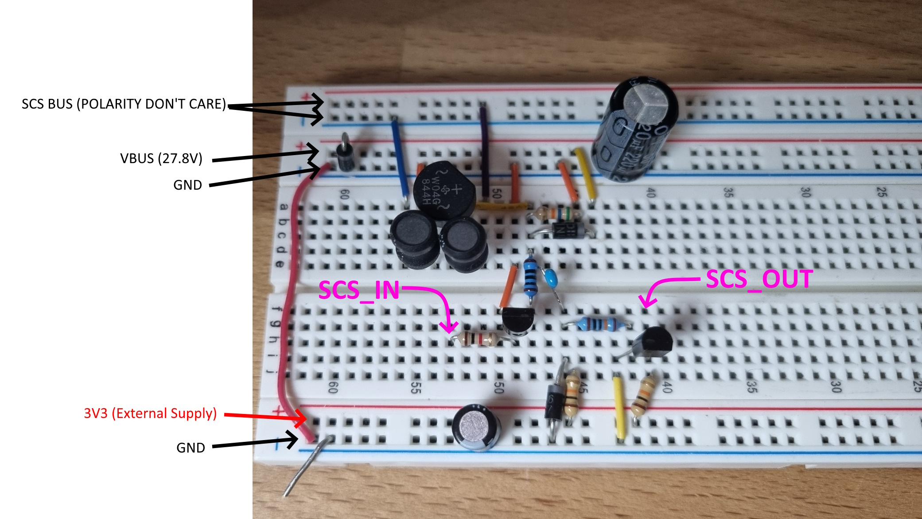
Hardware/SCS Interface V1/TestOnBreadboard.jpg
