JavaPowerFR/SCS/Hardware/SCS Interface V1/KiCad/SCS_Interface.kicad_pcb

## KiCad design Hardware/SCS Interface V1/KiCad/SCS_Interface.kicad_pcb (2024-05-30)

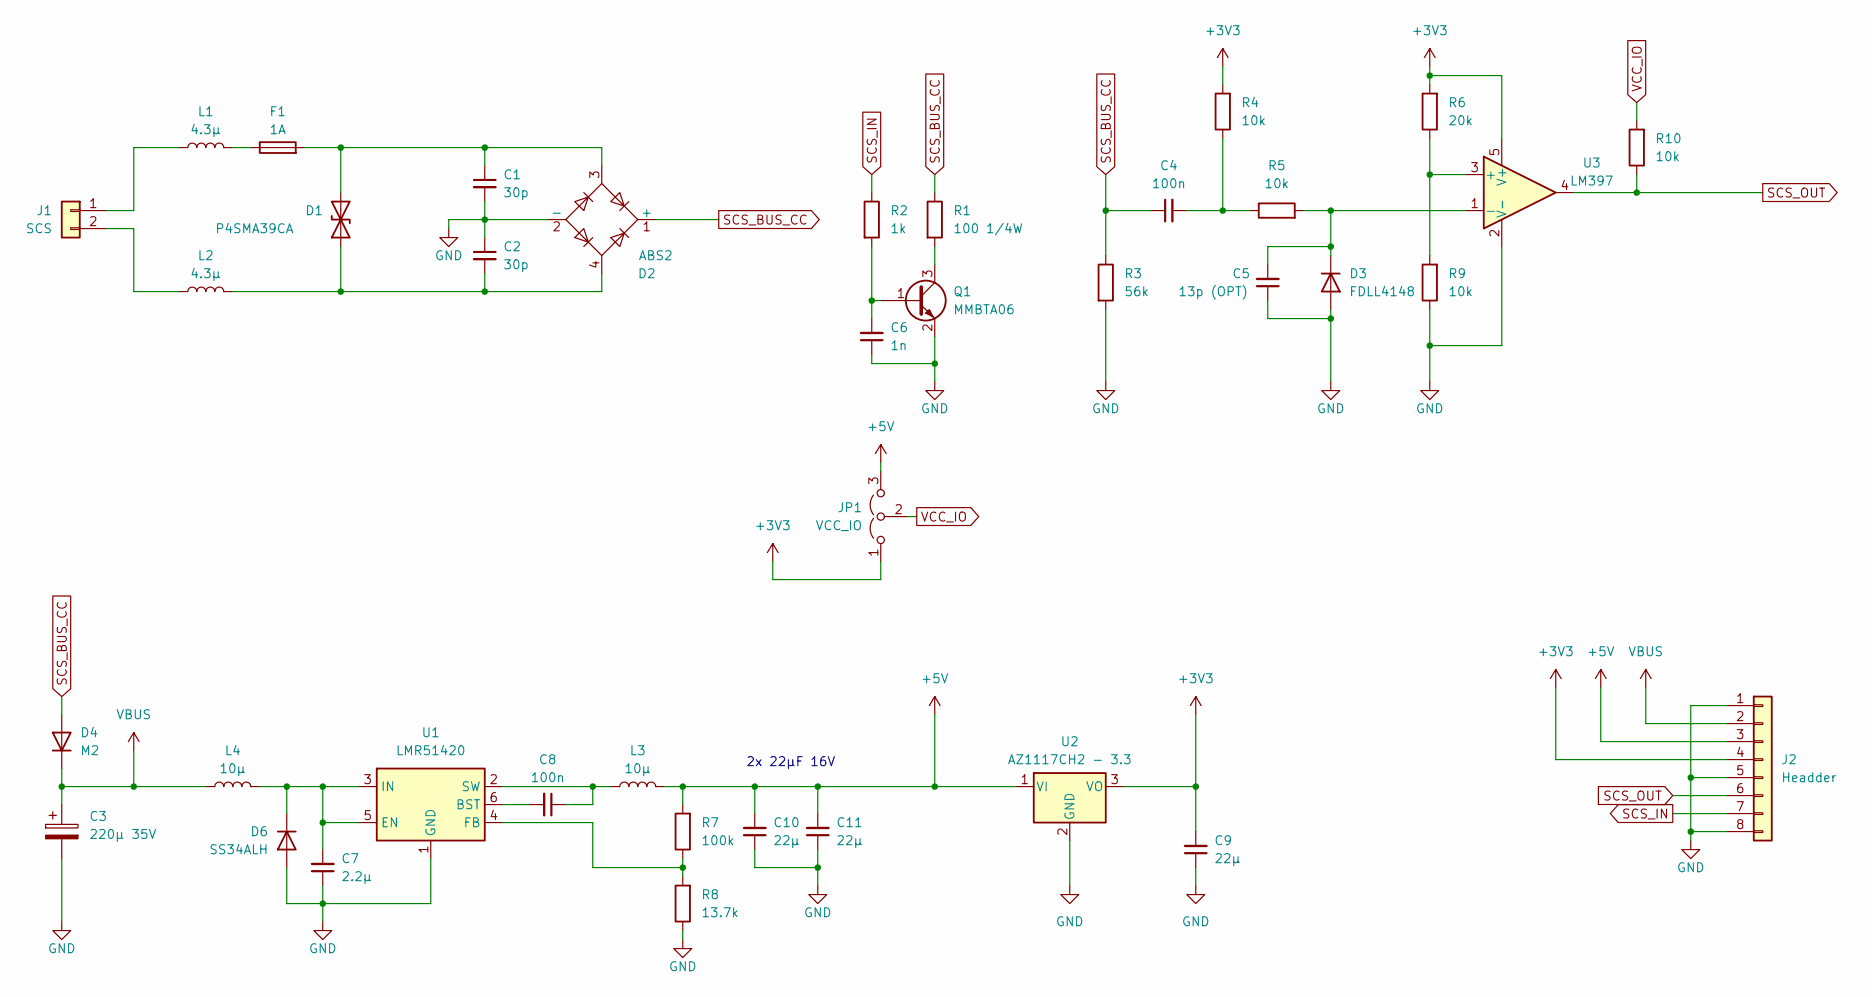
[picture p17: schematic SCS_Interface.kicad_sch]

Parts:
C1, C2: 30p; C_0805_2012Metric
C3: 220µ 35V; CP_Elec_8x10
C4, C8: 100n; C_0805_2012Metric
C5: 13p (OPT); C_0805_2012Metric
C6: 1n; C_0805_2012Metric
C7: 2.2µ; C_0805_2012Metric
C9, C10, C11: 22µ; C_0805_2012Metric
D1: P4SMA39CA; D_SMA
D2: ABS2; Diode_Bridge_Diotec_ABS
D3: FDLL4148; D_MiniMELF
D4: M2; D_SMA
D6: SS34ALH; D_SMA
F1: 1A; Fuse_1206_3216Metric_Pad1.42x1.75mm_HandSolder
J1: SCS; TerminalBlock_Phoenix_MKDS-1,5-2_1x02_P5.00mm_Horizontal_PNP
J2: Headder; PinHeader_1x08_P2.54mm_Vertical
JP1: VCC_IO; SolderJumper-3_P1.3mm_Open_RoundedPad1.0x1.5mm
L1, L2: 4.3µ; L_Wuerth_MAPI-3020
L3, L4: 10µ; L_Sunlord_SWPA6028S
Q1: MMBTA06; SOT-23
R1: 100 1/4W; R_1206_3216Metric
R2: 1k; R_0805_2012Metric
R3: 56k; R_0805_2012Metric
R4, R5, R9, R10: 10k; R_0805_2012Metric
R6: 20k; R_0805_2012Metric
R7: 100k; R_0805_2012Metric
R8: 13.7k; R_0805_2012Metric
U1: LMR51420; SOT-23-6
U2: AZ1117CH2 - 3.3; SOT-223-3_TabPin2
U3: LM397; SOT-23-5

Connections:
+3V3: C9.2, J2.4, JP1.1 (A), R4.2, R6.2, U2.3 (VO), U3.5 (V+)
+5V: C10.2, C11.2, J2.3, JP1.3 (B), L3.2, R7.2, U2.1 (VI)
GND: C1.2, C2.1, C3.2, C5.1, C6.1, C7.1, C9.1, C10.1, C11.1, D2.2 (-), D3.2 (A), D6.2 (A), J2.1, J2.5, J2.8, Q1.2 (E), R3.2, R8.1, R9.1, U1.1 (GND), U2.2 (GND), U3.2 (V-)
unnamed: C4.2, R4.1, R5.1
unnamed: C2.2, D1.1 (A1), D2.4, L2.2
unnamed: C1.1, D1.2 (A2), D2.3, F1.2
unnamed: C5.2, D3.1 (K), R5.2, U3.1 (-)
unnamed: C7.2, D6.1 (K), L4.2, U1.3 (IN), U1.5 (EN)
unnamed: F1.1, L1.2
unnamed: J1.1, L1.1
unnamed: J1.2, L2.1
unnamed: C6.2, Q1.1 (B), R2.2
unnamed: Q1.3 (C), R1.2
unnamed: C8.2, U1.6 (BST)
unnamed: R7.1, R8.2, U1.4 (FB)
unnamed: C8.1, L3.1, U1.2 (SW)
unnamed: R6.1, R9.2, U3.3 (+)
SCS_BUS_CC: C4.1, D2.1 (+), D4.2 (A), R1.1, R3.1
SCS_IN: J2.7, R2.1
SCS_OUT: J2.6, R10.1, U3.4
VBUS: C3.1, D4.1 (K), J2.2, L4.1
VCC_IO: JP1.2 (C), R10.2

Notes on the sheet:
2x 22µF 16V

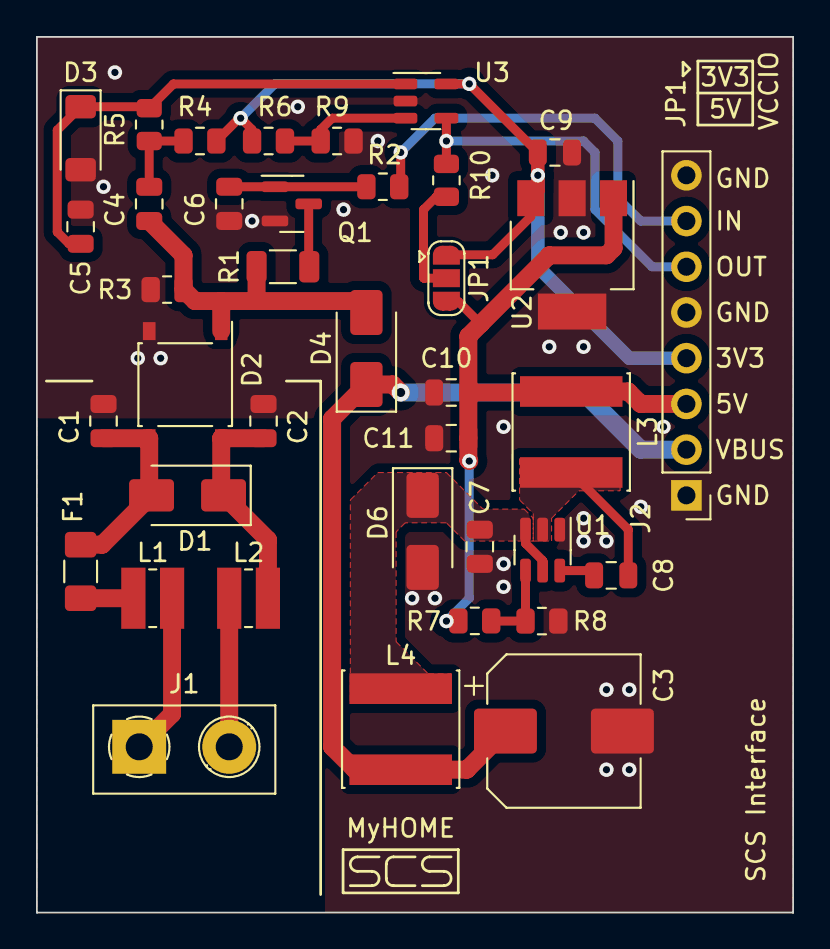
[picture p18: board SCS_Interface.kicad_pcb from above]

Board: 2 copper layers, 42.0 x 48.6 mm, 38 parts (0 on the bottom side), 22 nets.
