JavaPowerFR/SCS/Hardware/SCS Interface V1/KiCad/SCS_Interface_Lte.kicad_pcb

## KiCad design Hardware/SCS Interface V1/KiCad/SCS_Interface_Lte.kicad_pcb (2024-05-30)

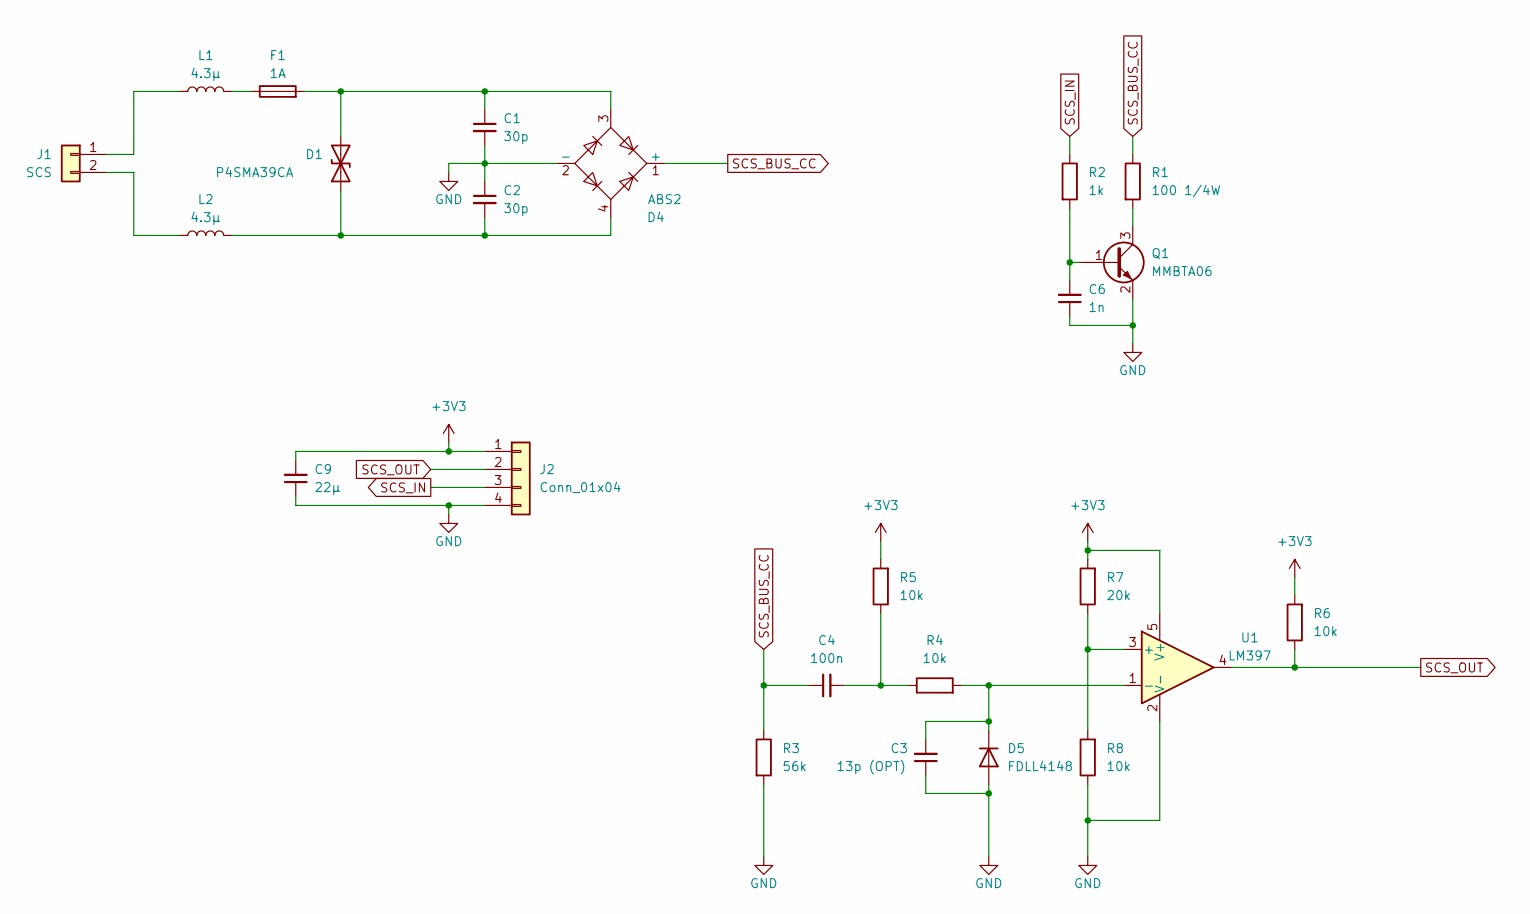
[picture p19: schematic SCS_Interface_Lte.kicad_sch]

Parts:
C1, C2: 30p; C_0805_2012Metric
C3: 13p (OPT); C_0805_2012Metric
C4: 100n; C_0805_2012Metric
C6: 1n; C_0805_2012Metric
C9: 22µ; C_0805_2012Metric
D1: P4SMA39CA; D_SMA
D4: ABS2; Diode_Bridge_Diotec_ABS
D5: FDLL4148; D_MiniMELF
F1: 1A; Fuse_1206_3216Metric_Pad1.42x1.75mm_HandSolder
J1: SCS; TerminalBlock_Phoenix_MKDS-1,5-2_1x02_P5.00mm_Horizontal_PNP
J2: Conn_01x04; PinHeader_1x04_P2.54mm_Vertical
L1, L2: 4.3µ; L_Wuerth_MAPI-3020
Q1: MMBTA06; SOT-23
R1: 100 1/4W; R_1206_3216Metric
R2: 1k; R_0805_2012Metric
R3: 56k; R_0805_2012Metric
R4, R5, R6, R8: 10k; R_0805_2012Metric
R7: 20k; R_0805_2012Metric
U1: LM397; SOT-23-5

Connections:
+3V3: C9.2, J2.1, R5.2, R6.2, R7.2, U1.5 (V+)
GND: C1.2, C2.1, C3.1, C6.1, C9.1, D4.2 (-), D5.2 (A), J2.4, Q1.2 (E), R3.2, R8.1, U1.2 (V-)
unnamed: C4.2, R4.1, R5.1
unnamed: C2.2, D1.1 (A1), D4.4, L2.2
unnamed: C1.1, D1.2 (A2), D4.3, F1.2
unnamed: C3.2, D5.1 (K), R4.2, U1.1 (-)
unnamed: F1.1, L1.2
unnamed: J1.1, L1.1
unnamed: J1.2, L2.1
unnamed: C6.2, Q1.1 (B), R2.2
unnamed: Q1.3 (C), R1.2
unnamed: R7.1, R8.2, U1.3 (+)
SCS_BUS_CC: C4.1, D4.1 (+), R1.1, R3.1
SCS_IN: J2.3, R2.1
SCS_OUT: J2.2, R6.1, U1.4

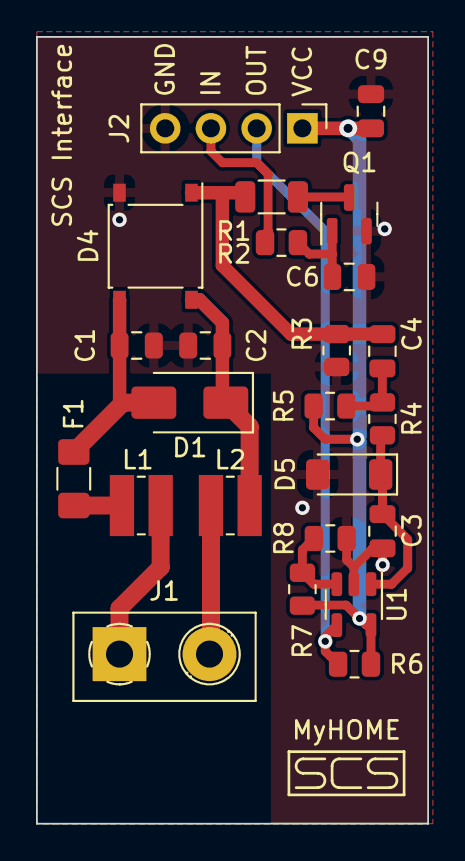
[picture p20: board SCS_Interface_Lte.kicad_pcb from above]

Board: 2 copper layers, 21.7 x 43.7 mm, 24 parts (0 on the bottom side), 15 nets.
