JavaPowerFR/SCS/(commit log)

2024-05-12 Schematic Interface SCS V1
    [SCS_Interface.kicad_pcb, SCS_Interface.kicad_sch, SCS_Interface_Lte.kicad_pcb, SCS_Interface_Lte.kicad_sch]
2024-05-12 Add KiCad project for scs interface V1
    [SCS_Interface.kicad_pcb, SCS_Interface.kicad_sch, SCS_Interface_Lte.kicad_pcb, SCS_Interface_Lte.kicad_sch]
2024-05-12 schematic V1 test On, Breadboard
2024-05-30 Update PCB after first pcb build
    - Replace input detection
    [SCS_Interface.kicad_pcb, SCS_Interface.kicad_sch, SCS_Interface_Lte.kicad_pcb, SCS_Interface_Lte.kicad_sch]
2024-06-03 Resources to decode scs packets
    [OPENDB_EN_OPEN.xlsx]
